TahaMunir2/ElectroMagnetic-FPGA-3D-Renderer/hardware/resistivetouchpanel.jpg

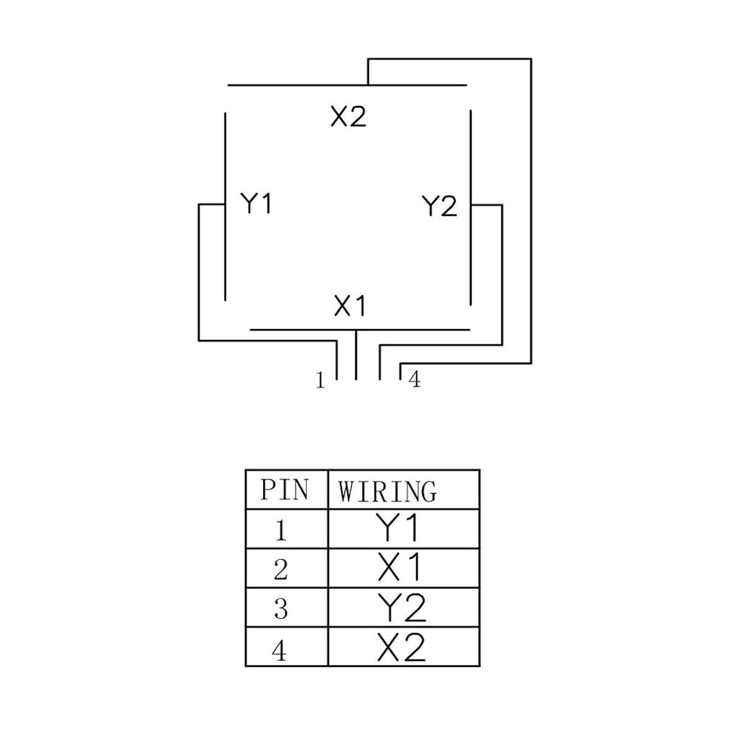
hardware/resistivetouchpanel.jpg
