TahaMunir2/ElectroMagnetic-FPGA-3D-Renderer/hardware_onepanel/fritzing/breadboard_diagram.png

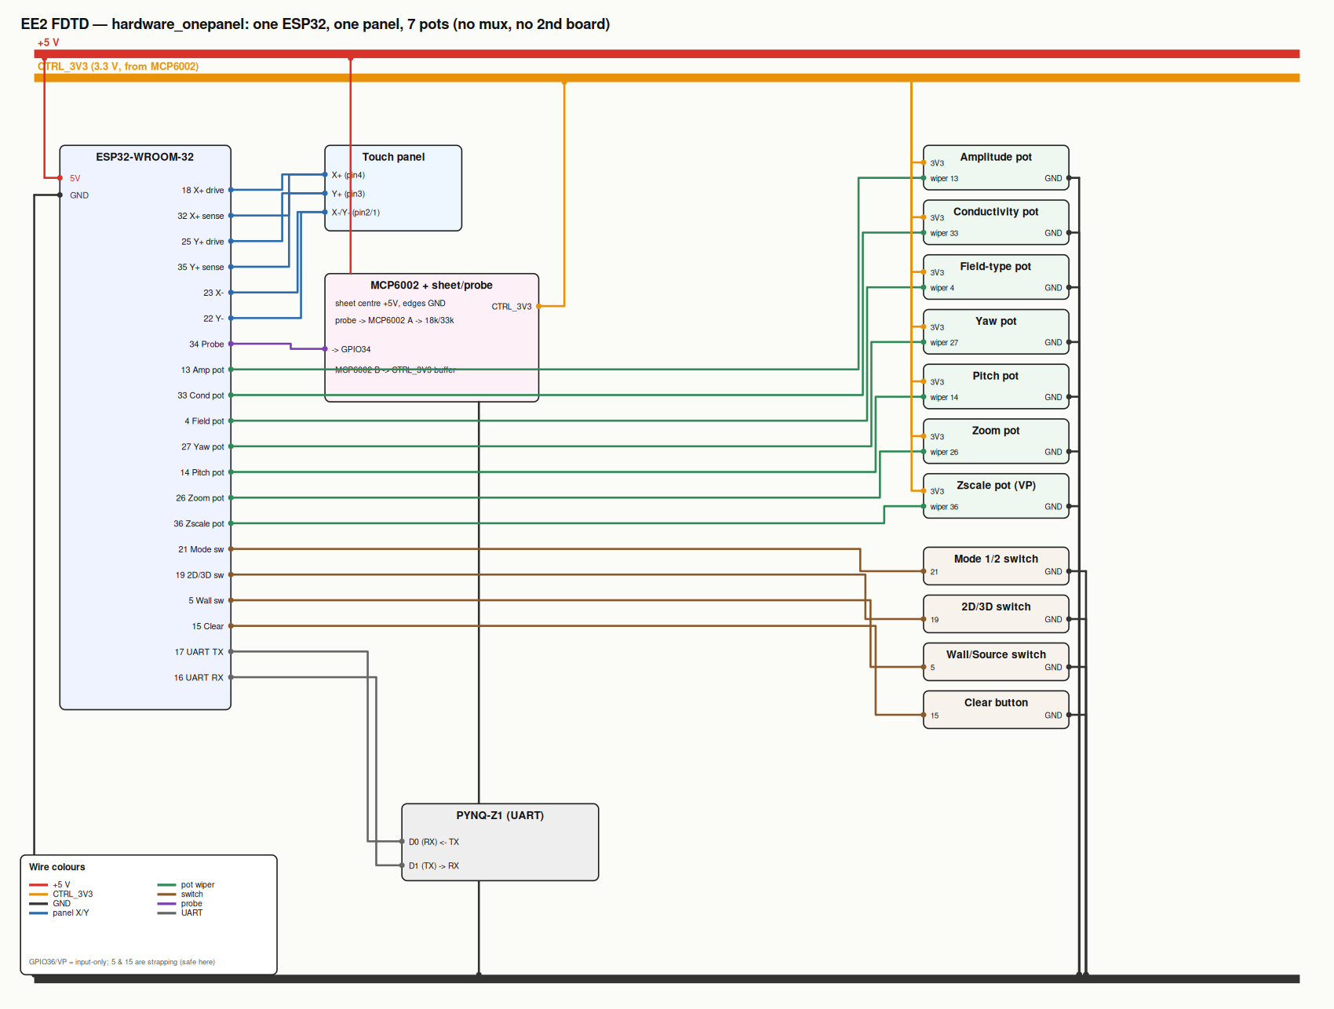
hardware_onepanel/fritzing/breadboard_diagram.png
