TahaMunir2/ElectroMagnetic-FPGA-3D-Renderer/hardware/cad/enclosure.stl

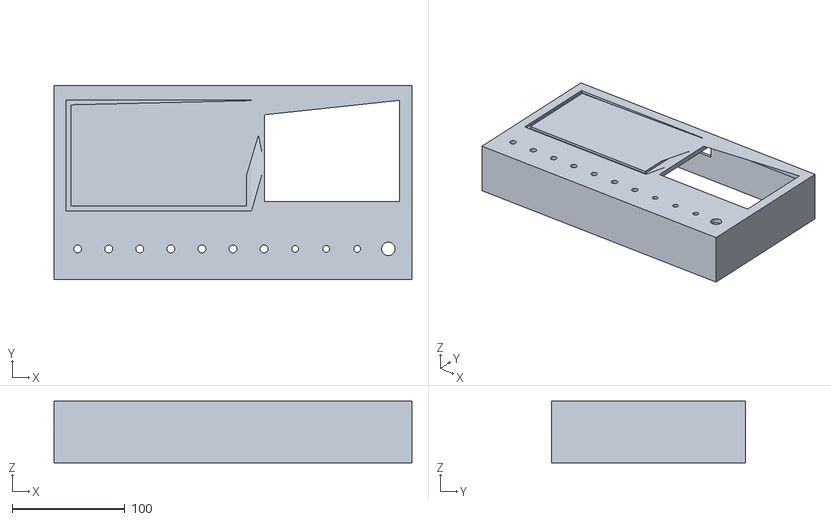
[picture p3: CAD file, 2026-06-06]
hardware/cad/enclosure.stl
318.0 x 172.0 x 55.0
