TahaMunir2/ElectroMagnetic-FPGA-3D-Renderer/hardware_onepanel/model/Paper_Frame.3mf

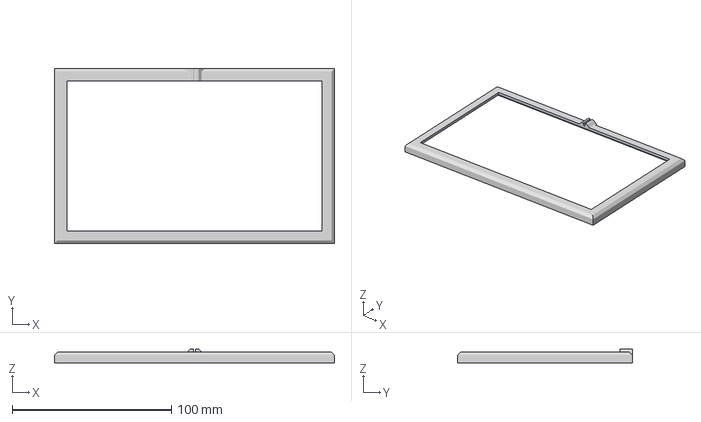
[picture p4: CAD file, 2026-06-09]
hardware_onepanel/model/Paper_Frame.3mf
176.0 x 110.0 x 9.00 mm
