TahaMunir2/ElectroMagnetic-FPGA-3D-Renderer/hardware_onepanel/model/BOX1.3mf

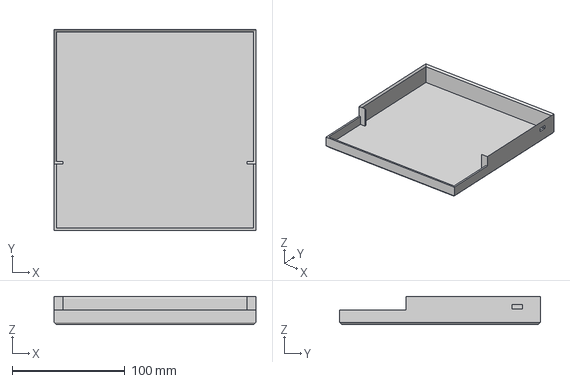
[picture p5: CAD file, 2026-06-09]
hardware_onepanel/model/BOX1.3mf
179.0 x 178.0 x 25.0 mm
