TahaMunir2/ElectroMagnetic-FPGA-3D-Renderer/hardware_onepanel/model/Panal_Frame.3mf

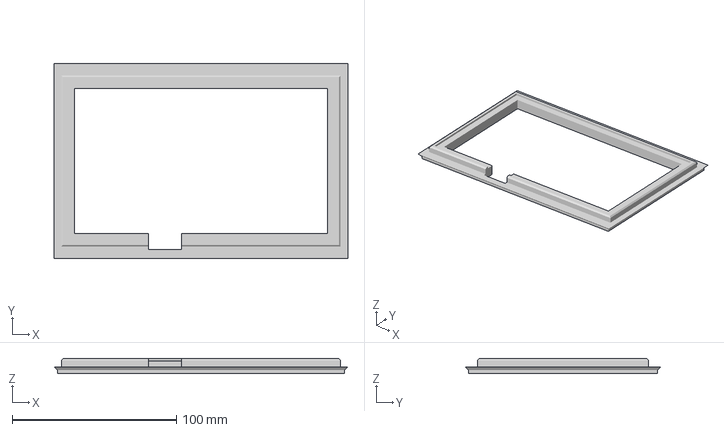
[picture p6: CAD file, 2026-06-09]
hardware_onepanel/model/Panal_Frame.3mf
179.0 x 119.0 x 9.00 mm
