TahaMunir2/ElectroMagnetic-FPGA-3D-Renderer/hardware_onepanel/model/BOX2.3mf

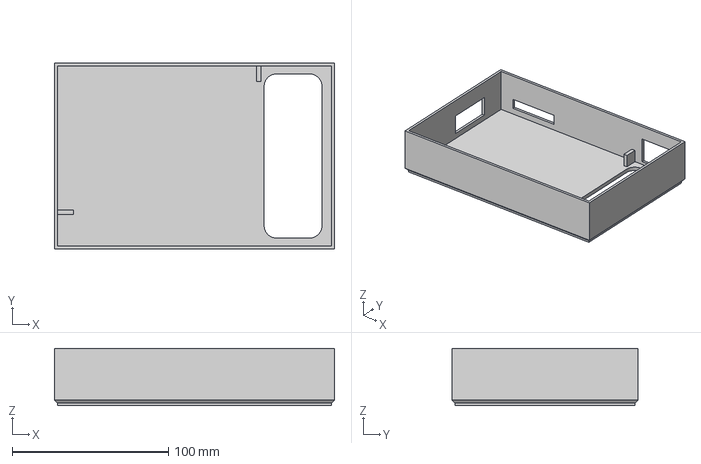
[picture p7: CAD file, 2026-06-09]
hardware_onepanel/model/BOX2.3mf
179.0 x 119.0 x 36.5 mm
