TahaMunir2/ElectroMagnetic-FPGA-3D-Renderer/hardware_onepanel/ltspice/pots.asc

AmpB: res; {rb}
AmpT: res; {rt}
CondB: res; {rb}
CondT: res; {rt}
FieldB: res; {rb}
FieldT: res; {rt}
Vctrl: voltage; 3.3
Named nets: CTRL_3V3, 0, 13, 33, 4
AMP 13
COND 33
FIELD 4
CONTROL POTS off CTRL_3V3 (3 fitted in this build). Wiper fraction = .param wiper.
.op
.param wiper=0.5 rt=10k*(1-wiper) rb=10k*wiper
CTRL_3V3 here stands in for the buffered 3.3 V rail (see power_3v3_rail.asc).
