TahaMunir2/ElectroMagnetic-FPGA-3D-Renderer/hardware_better/ltspice/dg413_panel_mux.asc

R_ym: res; 1G
R_yp: res; 1G
Rt1: res; {if(TOUCH1>0.5,RCONTACT,1G)}
Rt2: res; {if(TOUCH2>0.5,RCONTACT,1G)}
Rx1: res; {RPANEL}
Rx2: res; {RPANEL}
Ry1: res; {RPANEL}
Ry2: res; {RPANEL}
V_xp: voltage; 3.3
XNC: MANUAL_SPST_NC; STATE={sel}
XNO: MANUAL_SPST_NO; STATE={sel}
YNC: MANUAL_SPST_NC; STATE={sel}
YNO: MANUAL_SPST_NO; STATE={sel}
Named nets: ESP_XP, 0, ESP_YP, ESP_YM, P1_XP, P2_XP, P1_YP, P2_YP
DG413 PANEL MUX  --  shared 6-pin port routed to Panel 1 (Mode 1) or Panel 2 (Mode 2)
DG413 modelled as 2 NC + 2 NO switches on one select.  sel=0 -> NC on (Panel 1) ;  sel=1 -> NO on (Panel 2)
Only X+/Y+ are switched ; X-/Y- are common (X- = 0 here = read-X phase).  Idle panel's + lines are open -> inert.
X+ mux  (NC->P1 / NO->P2)
Y+ mux  (NC->P1 / NO->P2)
Panel 1   (Rx/Ry = layers, Rt = touch)
Panel 2
.op
.param sel=0 RPANEL=600 RCONTACT=2 TOUCH1=1 TOUCH2=0
Mode-2 test: set sel=1  TOUCH1=0  TOUCH2=1 . Expect V(ESP_YP) to follow the active panel only.
