TahaMunir2/ElectroMagnetic-FPGA-3D-Renderer/hardware_onepanel/ltspice/switches.asc

Rpu_c: res; 10k
Rpu_d: res; 10k
Rpu_m: res; 10k
Rpu_w: res; 10k
Vctrl: voltage; 3.3
XCLEAR: MANUAL_PUSH_NO; PRESS=0
XDISP: MANUAL_SPST_NO; STATE=0
XMODE: MANUAL_SPST_NO; STATE=0
XWALL: MANUAL_SPST_NO; STATE=0
Named nets: CTRL_3V3, 0, 21, 26, 27, 14
MODE 21
2D/3D 26
WALL 27
CLEAR 14
Mode / 2D-3D / Wall switches + Clear button -- pulled up to CTRL_3V3, switch to GND.
Closed / pressed = LOW (active). Firmware also enables the ESP32 internal pull-ups.
.op
Set STATE=1 / PRESS=1 on a switch to simulate it active.
