TahaMunir2/ElectroMagnetic-FPGA-3D-Renderer/hardware/ltspice/circuit_design_manual.asc

Conductivity: res; {rt}
Field: res; {rt}
Pitch: res; {rt}
Pm1: res; {rb}
Pm2: res; {rb}
Pm3: res; {rb}
Pm4: res; {rb}
Pm5: res; {rb}
Pm6: res; {rb}
Pm7: res; {rb}
R1: res; 18k
R2: res; 33k
R3: res; 10k
R4: res; 20k
R5: res; 18k
R6: res; 33k
Radc: res; 1G
Rg1: res; 1G
Rg2: res; 1G
Rpd: res; 10Meg
Rpu1: res; 10k
Rpu2: res; 10k
Rsheet_c: res; {rsc}
Rsheet_e: res; {rse}
Rt1: res; 1G
Rt2: res; 1G
Rx1: res; 600
Rx2: res; 600
Ry1: res; 600
Ry2: res; 600
U1: MCP6001
U2: MCP6001
V1: voltage; 5
Voltage: res; {rt}
XClear: MANUAL_PUSH_NO; PRESS=0
XDisp: MANUAL_SPDT; STATE=0
XMode: MANUAL_SPDT; STATE=0
XWall: MANUAL_SPST_NO; STATE=0
Yaw: res; {rt}
Z_Scale: res; {rt}
Zoom: res; {rt}
Named nets: V5, 0, VMID, VDD3V3, 39, 27, 14, 13, 4, 15, 36, COMMON_MODE, 35, COMMON_DISP, PROBE, PBUF, 34, 32, 23, 33, 22, 25, 21, 26, 19, 5, 18
EE2 ESP32 input front-end -- complete circuit
Nets are named by ESP32 GPIO number.  VDD3V3 = buffered 3.3 V rail.  Models auto-included via symbol ModelFile (no .include).
POWER -> VDD3V3
5 V -> 18k / 33k (~3.24 V) -> U1 unity follower
CONTROL POTS -> ADC GPIOs
wiper fraction = .param wiper ; top = {rt}, bottom = {rb}
YAW 39
PITCH 27
ZOOM 14
ZSCALE 13
AMP 4
COND 15
FIELD 36
MODE-1 SHEET + PROBE -> GPIO34
centre +5 V, edges GND ; V(PROBE)=5*(1-FRAC) ; U2 buffer ; 18k/33k ; Rpd 10M anti-float
MODE / 2D-3D ENCODER -> GPIO35
V(35) = (2*MODE + DISP) / 3 x VDD3V3
STATE 0: Mode1 / 2D    STATE 1: Mode2 / 3D
TOUCH PANELS (MCU-driven)
Panel 1 (Mode 1): X+ 32   Y+ 33   X- 23   Y- 22
Panel 2 (Mode 2): X+ 25   Y+ 26   X- 21   Y- 19
WALL SWITCH (GPIO5) + CLEAR BUTTON (GPIO18)
pull-ups to VDD3V3 ; idle HIGH, active LOW
.op
.param wiper=0.5 RSHEET=100k FRAC=0.5
.param rt=10k*(1-wiper) rb=10k*wiper rsc=RSHEET*FRAC rse=RSHEET*(1-FRAC)
