TahaMunir2/ElectroMagnetic-FPGA-3D-Renderer/hardware/ltspice/mode_encoder.asc

DISP: MANUAL_SPDT; STATE=0
MODE: MANUAL_SPDT; STATE=0
Radc: res; 1G
Rdisp: res; 20k
Rmode: res; 10k
Vctrl: voltage; 3.3
Named nets: CTRL_3V3, 0, COMMON_MODE, GPIO35_ENC, COMMON_DISP
Mode + 2D/3D encoder on one ADC pin (GPIO35).
Two SPDT switches select CTRL_3V3 / GND through a 10k (MSB=mode) and a
20k (LSB=display) weighted DAC. V(GPIO35_ENC) = (2*mode + disp)/3 * 3.3.
MODE: STATE=0 Mode1, STATE=1 Mode2
DISP: STATE=0 2D, STATE=1 3D
Radc 1G = high-Z ADC input
.op
Levels: 00->0  01->1/3  10->2/3  11->1 of 3.3V. Defaults shown = 0 (Mode1/2D).
