TahaMunir2/ElectroMagnetic-FPGA-3D-Renderer/hardware/ltspice/potentiometers.asc

Rb1: res; {10k*wiper}
Rb2: res; {10k*wiper}
Rb3: res; {10k*wiper}
Rb4: res; {10k*wiper}
Rb5: res; {10k*wiper}
Rb6: res; {10k*wiper}
Rb7: res; {10k*wiper}
Rt1: res; {10k*(1-wiper)}
Rt2: res; {10k*(1-wiper)}
Rt3: res; {10k*(1-wiper)}
Rt4: res; {10k*(1-wiper)}
Rt5: res; {10k*(1-wiper)}
Rt6: res; {10k*(1-wiper)}
Rt7: res; {10k*(1-wiper)}
Vctrl: voltage; 3.3
Named nets: CTRL_3V3, 0, GPIO39_YAW, GPIO27_PITCH, GPIO14_ZOOM, GPIO13_ZSCALE, GPIO4_AMP, GPIO15_COND, GPIO36_FIELD
7 control pots modelled as top/bottom dividers off CTRL_3V3.
'wiper' = wiper fraction 0..1; node voltage = 3.3*wiper. CTRL_3V3 here stands in
for the buffered rail (see power_3v3_rail.asc).
YAW (39)
PITCH (27)
ZOOM (14)
ZSCALE (13)
AMP (4)
COND (15)
FIELD (36)
.op
.param wiper=0.5
