TahaMunir2/ElectroMagnetic-FPGA-3D-Renderer/hardware/ltspice/switches_buttons.asc

CLEAR: MANUAL_PUSH_NO; PRESS=0
Rpu1: res; 10k
Rpu2: res; 10k
Vctrl: voltage; 3.3
WALL: MANUAL_SPST_NO; STATE=0
Named nets: CTRL_3V3, 0, GPIO5_WALL, GPIO18_CLEAR
Wall/Source switch (GPIO5) and Clear button (GPIO18), pulled up to CTRL_3V3.
Idle = HIGH; switch closed / button pressed = LOW (active-low at the GPIO).
WALL: STATE=0 source/HIGH, STATE=1 wall/LOW
CLEAR: PRESS=0 idle/HIGH, PRESS=1 clear/LOW
.op
