TahaMunir2/ElectroMagnetic-FPGA-3D-Renderer/hardware_onepanel/ltspice/power_3v3_rail.asc

R1: res; 1.7k
R2: res; 3.3k
Rload: res; 1k
U1: MCP6001
V1: voltage; 5
Named nets: +5V, 0, VREF, CTRL_3V3
EE2 power section: 5V -> buffered 3.3V control rail (CTRL_3V3).
MCP6001 = one half of the MCP6002; the other half is the probe buffer.
Rload = lumped pots / encoder / pull-ups (~1k)
.op
Divider 1.7k/3.3k -> ~3.3V (use 1.69k E96 for exact); op-amp buffers it.
Expect V(CTRL_3V3) ~ 3.3V. MCP6001.lib is pulled in by the symbol.
