TahaMunir2/ElectroMagnetic-FPGA-3D-Renderer/hardware_onepanel/ltspice/probe_sheet.asc

Rdiv1: res; 18k
Rdiv2: res; 33k
Rpd: res; 10Meg
Rsheet_c: res; {RSHEET*FRAC}
Rsheet_e: res; {RSHEET*(1-FRAC)}
U1: MCP6001
V5: voltage; 5
Named nets: +5V, 0, PROBE, PBUF, GPIO34_PROBE
Mode 1 conducting sheet + probe. Centre electrode = +5V, four edges = GND.
FRAC = probe distance centre->edge (0..1); V(PROBE) = 5*(1-FRAC).
MCP6001 = half A of the MCP6002 (unity-gain buffer, Rin huge).
18k/33k scales the <=5V probe to <=3.3V at GPIO34. Rpd 10M stops a floating probe.
10M pull-down
.op
.param RSHEET=100k FRAC=0.5
