TahaMunir2/ElectroMagnetic-FPGA-3D-Renderer/hardware_onepanel/ltspice/touch_panel.asc

R_ym: res; 1G
R_yp: res; 1G
Rtouch: res; {if(TOUCH>0.5,RCONTACT,1G)}
Rxa: res; {RPANEL*KX}
Rxb: res; {RPANEL*(1-KX)}
Rya: res; {RPANEL*KY}
Ryb: res; {RPANEL*(1-KY)}
Vxdrive: voltage; 3.3
Vxm: voltage; 0
Named nets: GPIO32_XP, 0, GPIO23_XM, TPX, TPY, GPIO33_YP, GPIO22_YM
4-wire resistive touch panel (Panel 1), shown in the READ-X phase:
XP=HIGH (GPIO32), XM=LOW (GPIO23), Y layer floats, ADC reads V(GPIO33_YP).
To read Y: drive YP/YM, float X, read XP. Touch via TOUCH; position via KX/KY.
Panel 2 (Mode 2) is identical on GPIO25/26 (X+/Y+) and GPIO21/19 (X-/Y-).
touch bridge
ADC high-Z (read X)
.op
.param RPANEL=600 KX=0.5 KY=0.5 TOUCH=1 RCONTACT=2
