TahaMunir2/ElectroMagnetic-FPGA-3D-Renderer/src/hdl/fsm_controller.v

/**
 * FSM Controller - Orchestration for 1D FDTD Solver
 * 
 * Manages state transitions and control signals for system integration
 * 
 * States:
 *   IDLE      - Waiting for start command
 *   INIT      - Initialize BRAM with zero values
 *   SOURCE_GEN - Generate CORDIC source waveform
 *   SOLVE     - Execute FDTD solver iterations
 *   READ_OUT  - Read final field values
 *   DONE      - Simulation complete, awaiting readout
 */

module fsm_controller (
    input  wire clk,
    input  wire rst,
    
    // Control inputs
    input  wire start,
    input  wire [15:0] num_iterations,
    
    // Module enable signals
    output wire cordic_enable,
    output wire solver_enable,
    output wire bram_init_enable,
    
    // Status outputs
    output wire [2:0] current_state,
    output wire fsm_done
);

    // State encoding
    localparam IDLE      = 3'b000;
    localparam INIT      = 3'b001;
    localparam SOURCE_GEN = 3'b010;
    localparam SOLVE     = 3'b011;
    localparam READ_OUT  = 3'b100;
    localparam DONE      = 3'b101;

    // TODO: Implement FSM
    // 
    // State machine transitions:
    // IDLE -> INIT (on start signal)
    // INIT -> SOURCE_GEN (after initialization complete)
    // SOURCE_GEN -> SOLVE (after source preparation)
    // SOLVE -> READ_OUT (after iterations complete)
    // READ_OUT -> DONE (after readout complete)
    // DONE -> IDLE (wait for next start)
    //
    // Key considerations:
    // 1. Coordinate between module start/done signals
    // 2. Manage iteration counter for SOLVE phase
    // 3. Synchronize CORDIC output with FDTD solver input
    // 4. Handle BRAM access conflicts

    // Placeholder: Remove after implementation
    assign cordic_enable = 1'b0;
    assign solver_enable = 1'b0;
    assign bram_init_enable = 1'b0;
    assign current_state = IDLE;
    assign fsm_done = 1'b0;

endmodule
