TahaMunir2/ElectroMagnetic-FPGA-3D-Renderer/src/hdl/top_fdtd_solver.v

/**
 * Top-Level 1D FDTD Solver Module
 * 
 * Integrates:
 * - BRAM module
 * - CORDIC sine wave generator
 * - FDTD solver core
 * - FSM controller
 * - Output interface
 */

module top_fdtd_solver #(
    parameter CELLS = 64,
    parameter CELL_WIDTH = 6,
    parameter DATA_WIDTH = 16,
    parameter ADDR_WIDTH = 6
)(
    // Clock and Reset
    input  wire clk,
    input  wire rst,
    
    // User interface
    input  wire start,
    input  wire [15:0] num_iterations,
    input  wire [15:0] source_freq,      // Source frequency in fixed-point
    
    // Output interfaces
    output wire [DATA_WIDTH-1:0] ey_out [CELLS-1:0],  // Final Ey values
    output wire [DATA_WIDTH-1:0] bz_out [CELLS-1:0],  // Final Bz values
    output wire out_valid,
    output wire out_ready
);

    // Internal signals
    wire cordic_enable, solver_enable, bram_init_enable;
    wire [2:0] current_state;
    wire fsm_done;
    
    // BRAM interface
    wire [ADDR_WIDTH-1:0] ey_addr_a, ey_addr_b;
    wire [DATA_WIDTH-1:0] ey_din_a, ey_din_b;
    wire                  ey_we_a, ey_we_b;
    wire [DATA_WIDTH-1:0] ey_dout_a, ey_dout_b;
    
    wire [ADDR_WIDTH-1:0] bz_addr_a, bz_addr_b;
    wire [DATA_WIDTH-1:0] bz_din_a, bz_din_b;
    wire                  bz_we_a, bz_we_b;
    wire [DATA_WIDTH-1:0] bz_dout_a, bz_dout_b;
    
    // CORDIC interface
    wire [DATA_WIDTH-1:0] sin_out, cos_out;
    wire cordic_valid;
    
    // TODO: Instantiate and integrate modules
    //
    // Module instantiation order:
    // 1. FSM Controller
    // 2. BRAM (dual instance for Ey and Bz)
    // 3. CORDIC Generator
    // 4. FDTD Solver
    // 5. Output MUX/Register stage
    //
    // Signal routing:
    // - Connect FSM enable signals to each module
    // - Route CORDIC sine output to FDTD solver source input
    // - Multiplex BRAM access between read-only output stage and FDTD solver
    // - Latch final field values for output

    // Placeholder: Remove after implementation
    assign out_valid = 1'b0;
    assign out_ready = 1'b0;
    
    genvar i;
    generate
        for (i = 0; i < CELLS; i = i + 1) begin : gen_outputs
            assign ey_out[i] = 16'b0;
            assign bz_out[i] = 16'b0;
        end
    endgenerate

endmodule
