TahaMunir2/ElectroMagnetic-FPGA-3D-Renderer/src/hdl/bram_module.v

/**
 * BRAM Module - Dual Port RAM for FDTD Solver
 * 
 * Owner: Yi
 * 
 * Stores Ey and Bz field values for 64-cell 1D FDTD grid
 * Q3.13 fixed-point precision (16-bit words)
 */

module bram_module #(
    parameter DEPTH = 64,
    parameter WIDTH = 16,
    parameter ADDR_WIDTH = 6
)(
    // Clock and Reset
    input  wire clk,
    input  wire rst,
    
    // Port A - Ey data
    input  wire                   we_a,
    input  wire [ADDR_WIDTH-1:0]  addr_a,
    input  wire [WIDTH-1:0]       din_a,
    output wire [WIDTH-1:0]       dout_a,
    
    // Port B - Bz data
    input  wire                   we_b,
    input  wire [ADDR_WIDTH-1:0]  addr_b,
    input  wire [WIDTH-1:0]       din_b,
    output wire [WIDTH-1:0]       dout_b
);

    // TODO: Implement dual-port BRAM
    // Consider using Xilinx BRAM IP for optimal resource utilization
    // 
    // Implementation notes:
    // 1. Initialize both memories with zeros
    // 2. Implement synchronous write and read
    // 3. Support simultaneous access on both ports
    // 4. Add optional write-enable for each port
    
    // Placeholder: Remove after implementation
    assign dout_a = 16'b0;
    assign dout_b = 16'b0;

endmodule
