TahaMunir2/ElectroMagnetic-FPGA-3D-Renderer/src/hdl/cordic_generator.v

/**
 * CORDIC Input Generator - Sine Wave Generator
 * 
 * Owner: Yi
 * 
 * Uses Xilinx CORDIC IP to generate sine/cosine waves
 * Outputs in Q3.13 fixed-point format for hard source excitation
 */

module cordic_generator (
    // Clock and Reset
    input  wire clk,
    input  wire rst,
    
    // Input phase (16-bit angle representation)
    input  wire [15:0] phase_in,
    input  wire        phase_valid,
    
    // Output sine and cosine (Q3.13 fixed-point)
    output wire [15:0] sin_out,
    output wire [15:0] cos_out,
    output wire        out_valid
);

    // TODO: Implement CORDIC wrapper
    // 
    // Implementation steps:
    // 1. Instantiate Xilinx CORDIC IP core
    // 2. Implement phase accumulator for frequency generation
    // 3. Format outputs as Q3.13 fixed-point
    // 4. Handle pipeline delays from CORDIC IP
    // 5. Add input/output registers for timing
    //
    // Phase accumulator configuration:
    // - Input frequency control
    // - Output normalized phase (0 to 2π)
    
    // Placeholder: Remove after implementation
    assign sin_out  = 16'b0;
    assign cos_out  = 16'b0;
    assign out_valid = 1'b0;

endmodule
