TahaMunir2/ElectroMagnetic-FPGA-3D-Renderer/src/hdl/fdtd_solver.v

/**
 * FDTD Solver Module - 1D Electromagnetic Field Update
 * 
 * Owner: Taha
 * 
 * Implements 1D FDTD algorithm with:
 * - 1D Ey (electric) and Bz (magnetic) components
 * - 64-cell grid
 * - Q3.13 fixed-point arithmetic
 * - Hard source excitation
 */

module fdtd_solver #(
    parameter CELLS = 64,
    parameter CELL_WIDTH = 6,
    parameter DATA_WIDTH = 16
)(
    // Clock and Reset
    input  wire clk,
    input  wire rst,
    
    // Hard source input (Q3.13)
    input  wire [DATA_WIDTH-1:0] source_in,
    input  wire                  source_valid,
    input  wire [CELL_WIDTH-1:0] source_idx,  // Source cell index
    
    // BRAM interface for Ey
    output wire [CELL_WIDTH-1:0] ey_addr,
    output wire [DATA_WIDTH-1:0] ey_din,
    output wire                  ey_we,
    input  wire [DATA_WIDTH-1:0] ey_dout,
    
    // BRAM interface for Bz
    output wire [CELL_WIDTH-1:0] bz_addr,
    output wire [DATA_WIDTH-1:0] bz_din,
    output wire                  bz_we,
    input  wire [DATA_WIDTH-1:0] bz_dout,
    
    // Control
    input  wire solver_enable,
    output wire solver_done
);

    // TODO: Implement FDTD solver
    // 
    // Algorithm (per time step):
    // 1. Read Bz values from BRAM
    // 2. Calculate Ey updates: Ey(k) = Ey(k) + C_e * (Bz(k+1) - Bz(k))
    // 3. Apply hard source: Ey(source_idx) = source_value
    // 4. Write updated Ey to BRAM
    // 5. Read Ey values from BRAM
    // 6. Calculate Bz updates: Bz(k) = Bz(k) + C_m * (Ey(k) - Ey(k+1))
    // 7. Apply boundary conditions (zero at edges)
    // 8. Write updated Bz to BRAM
    //
    // Fixed-point operations:
    // - Multiply: (a * b) >> 13 (Q3.13 * Q3.13 = Q6.26 >> 13 = Q3.13)
    // - Add/Subtract: Direct (Q3.13 + Q3.13 = Q3.13 with saturation)
    //
    // FDTD coefficients (update with actual values):
    // - C_e, C_m determined by CFL condition and material parameters

    // Placeholder: Remove after implementation
    assign ey_addr = 6'b0;
    assign ey_din = 16'b0;
    assign ey_we = 1'b0;
    assign bz_addr = 6'b0;
    assign bz_din = 16'b0;
    assign bz_we = 1'b0;
    assign solver_done = 1'b0;

endmodule
