TahaMunir2/ElectroMagnetic-FPGA-3D-Renderer/(commit log)

2026-06-04 Add hardware-design branch with folder structure
    Adds organized directories for Arduino board files, Fritzing breadboard designs,
    LTSpice circuit designs, and CAD 3D model files.
2026-06-06 Add hardware design files
    [enclosure.scad, enclosure.stl]
2026-06-06 Add hardware_better: DG413 two-panel input subsystem
    6-pin split drive/sense panels shared via a DG413 mux (mode-selected),
    reduced pots (amp/cond/field), separate mode & 2D/3D switch pins.
    Includes ESP32 firmware + panel1 test, LTSpice section schematics,
    breadboard wiring guide + diagram, and overview/pin_connections docs.
2026-06-09 Add hardware_onepanel: single ESP32, single panel input subsystem
    One board serves both modes via one directly-wired resistive panel (no DG413,
    no second board). Panel press -> calibrated full-scale (X 0-1023 / Y 0-612) ->
    fitted to a 64x38 grid (X 0-63 / Y 0-37); sent over UART2 to the PYNQ PS, which
    forwards each 21-byte frame as the UDP payload. Two-corner NVS calibration.
    Includes firmware + bring-up sketches, overview/pin docs, LTSpice, Fritzing.
    [BOX1.3mf, BOX2.3mf, Panal_Frame.3mf, Paper_Frame.3mf]
2026-06-14 Update ESP32 input firmware to support 128x128 grid cell mapping and improve coordinate validation
2026-06-14 Revise feature descriptions and dimensions in report
    Updated descriptions of the touch-panel window and cable slot dimensions. Revised details about the mounting of breadboards and FPGA board.
